aradian/MultiSpectLED/pcb-Kicad/MultiSpectLED/MultiSpectLED.kicad_pcb

## KiCad design pcb-Kicad/MultiSpectLED/MultiSpectLED.kicad_pcb (2022-05-28)

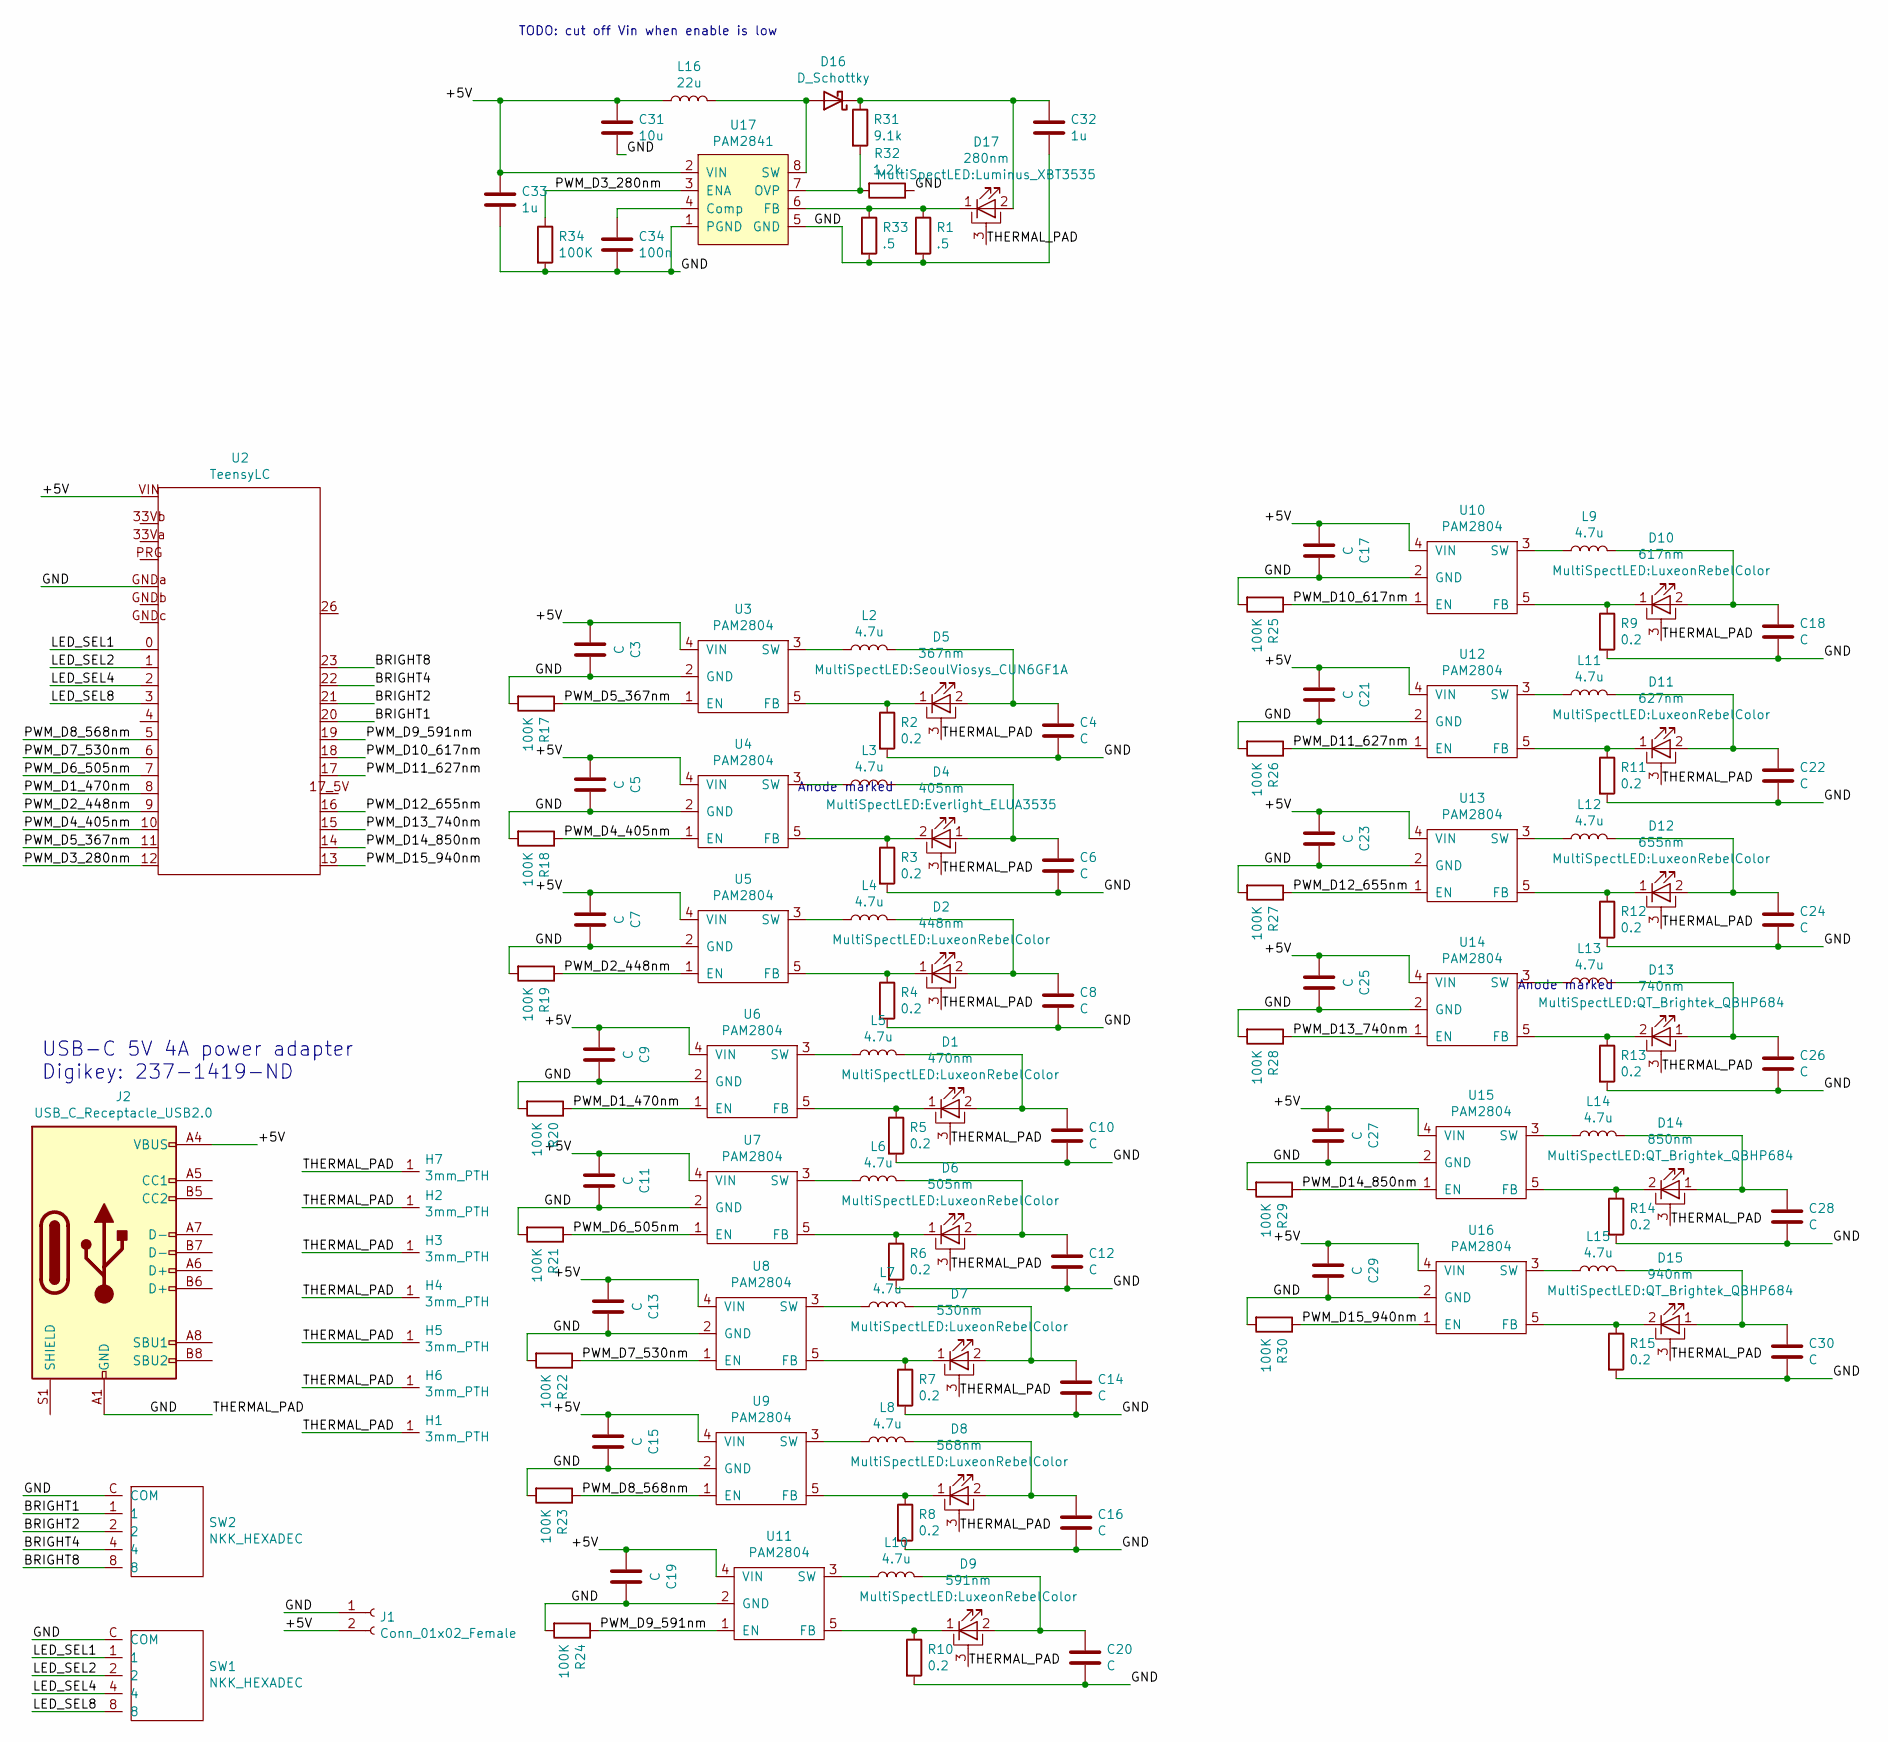
[picture p1: schematic MultiSpectLED.sch]

Parts:
C3, C4, C5, C6, C7, C8, C9, C10, C11, C12, C13, C14, C15, C16, C17, C18, C19, C20, C21, C22, C23, C24, C25, C26, C27, C28, C29, C30: C; C_0805_2012Metric; Digikey Part Number 490-3886-1-ND
C31: 10u; C_0805_2012Metric; Digi-Key_PN 1276-2891-1-ND
C32, C33: 1u; C_0805_2012Metric; Digi-Key_PN 1276-1066-1-ND
C34: 100n; C_0402_1005Metric; Digi-Key_PN 1276-1043-1-ND
D1: 470nm; LuxeonRebelColor; Digikey Part Number 1416-1029-1-ND
D2: 448nm; LuxeonRebelColor; Digikey Part Number 1416-1038-1-ND
D4: 405nm; Everlight_ELUA3535; Digikey Part Number 1080-1620-1-ND
D5: 367nm; SeoulViosys_CUN6GF1A; Digikey Part Number 2112-CUN6GF1ACT-ND
D6: 505nm; LuxeonRebelColor; Digikey Part Number 1416-1031-1-ND
D7: 530nm; LuxeonRebelColor; Digikey Part Number 1416-1036-1-ND
D8: 568nm; LuxeonRebelColor; Digikey Part Number 1416-1185-1-ND
D9: 591nm; LuxeonRebelColor; Digikey Part Number 1416-1027-1-ND
D10: 617nm; LuxeonRebelColor; Digikey Part Number 1416-1026-1-ND
D11: 627nm; LuxeonRebelColor; Digikey Part Number 1416-1024-1-ND
D12: 655nm; LuxeonRebelColor; Digikey Part Number 1416-1701-1-ND
D13: 740nm; QT_Brightek_QBHP684; Digikey Part Number 1516-1213-1-ND
D14: 850nm; QT_Brightek_QBHP684
D15: 940nm; QT_Brightek_QBHP684
D16: D_Schottky; D_TUMD2; Digi-Key_PN MSS2P2-M3/89AGICT-ND
D17: 280nm; Luminus_XBT3535; Digikey Part Number 1214-XBT-3535-UV-A130-CD270-00CT-ND
H1, H2, H3, H4, H5, H6, H7: 3mm_PTH
J1: Conn_01x02_Female; FAN_PADS
J2: USB_C_Receptacle_USB2.0; USB_C_Receptacle_Amphenol_12401610E4-2A; Digikey Part Number 12401610E4#2ACT-ND
L2, L3, L4, L5, L6, L7, L8, L9, L10, L11, L12, L13, L14, L15: 4.7u; L_1007_2518Metric; Digikey Part Number 587-1621-1-ND
L16: 22u; L_Taiyo-Yuden_NR-50xx; Digikey Part Number 587-NRS5040T220MMGKCT-ND
R1, R33: .5; R_0603_1608Metric; Digi-Key_PN CSR0603FKR500CT-ND
R2, R3, R4, R5, R6, R7, R8, R9, R10, R11, R12, R13, R14, R15: 0.2; R_0805_2012Metric; Digikey Part Number RL12S.20FCT-ND
R17, R18, R19, R20, R21, R22, R23, R24, R25, R26, R27, R28, R29, R30, R34: 100K; R_0402_1005Metric; Digikey Part Number RC1005F104CS
R31: 9.1k; R_0402_1005Metric; Digi-Key_PN RMCF0402FT9K10CT-ND
R32: 1.2k; R_0402_1005Metric; Digi-Key_PN RMCF0402FT1K20CT-ND
SW1, SW2: NKK_HEXADEC; NKK_FR02; Digikey Part Number 360-2543-1-ND
U2: TeensyLC; Digikey Part Number 1568-1233-ND
U3, U4, U5, U6, U7, U8, U9, U10, U11, U12, U13, U14, U15, U16: PAM2804; SOT-23-5; Digikey Part Number PAM2804AAB010DICT-ND
U17: PAM2841; MSOP-8_3x3mm_P0.65mm

Connections:
/+5V: C3.2, C5.2, C7.2, C9.2, C11.2, C13.2, C15.2, C17.2, C19.2, C21.2, C23.2, C25.2, C27.2, C29.2, C31.2, C33.1, J1.2, J2.A4 (VBUS), J2.A9 (VBUS), J2.B4 (VBUS), J2.B9 (VBUS), L16.1, U2.VIN, U3.4 (VIN), U4.4 (VIN), U5.4 (VIN), U6.4 (VIN), U7.4 (VIN), U8.4 (VIN), U9.4 (VIN), U10.4 (VIN), U11.4 (VIN), U12.4 (VIN), U13.4 (VIN), U14.4 (VIN), U15.4 (VIN), U16.4 (VIN), U17.2 (VIN)
/BRIGHT1: SW2.1, U2.20
/BRIGHT2: SW2.2, U2.21
/BRIGHT4: SW2.4, U2.22
/BRIGHT8: SW2.8, U2.23
/GND: C3.1, C4.2, C5.1, C6.2, C7.1, C8.2, C9.1, C10.2, C11.1, C12.2, C13.1, C14.2, C15.1, C16.2, C17.1, C18.2, C19.1, C20.2, C21.1, C22.2, C23.1, C24.2, C25.1, C26.2, C27.1, C28.2, C29.1, C30.2, C31.1, C32.2, C33.2, C34.2, D1.3 (PAD), D2.3 (PAD), D4.3 (PAD), D5.3 (PAD), D6.3 (PAD), D7.3 (PAD), D8.3 (PAD), D9.3 (PAD), D10.3 (PAD), D11.3 (PAD), D12.3 (PAD), D13.3 (PAD), D14.3 (PAD), D15.3 (PAD), D17.3 (PAD), H1.1, H2.1, H3.1, H4.1, H5.1, H6.1, H7.1, J1.1, J2.A1 (GND), J2.A12 (GND), J2.B1 (GND), J2.B12 (GND), R1.2, R2.2, R3.2, R4.2, R5.2, R6.2, R7.2, R8.2, R9.2, R10.2, R11.2, R12.2, R13.2, R14.2, R15.2, R17.2, R18.2, R19.2, R20.2, R21.2, R22.2, R23.2, R24.2, R25.2, R26.2, R27.2, R28.2, R29.2, R30.2, R32.1, R33.2, R34.2, SW1.C (COM), SW2.C (COM), U2.GNDa, U3.2 (GND), U4.2 (GND), U5.2 (GND), U6.2 (GND), U7.2 (GND), U8.2 (GND), U9.2 (GND), U10.2 (GND), U11.2 (GND), U12.2 (GND), U13.2 (GND), U14.2 (GND), U15.2 (GND), U16.2 (GND), U17.1 (PGND), U17.5 (GND)
/LED_SEL1: SW1.1, U2.0
/LED_SEL2: SW1.2, U2.1
/LED_SEL4: SW1.4, U2.2
/LED_SEL8: SW1.8, U2.3
/PWM_D1_470nm: R20.1, U2.8, U6.1 (EN)
/PWM_D2_448nm: R19.1, U2.9, U5.1 (EN)
/PWM_D3_280nm: R34.1, U2.12, U17.3 (ENA)
/PWM_D4_405nm: R18.1, U2.10, U4.1 (EN)
/PWM_D5_367nm: R17.1, U2.11, U3.1 (EN)
/PWM_D6_505nm: R21.1, U2.7, U7.1 (EN)
/PWM_D7_530nm: R22.1, U2.6, U8.1 (EN)
/PWM_D8_568nm: R23.1, U2.5, U9.1 (EN)
/PWM_D9_591nm: R24.1, U2.19, U11.1 (EN)
/PWM_D10_617nm: R25.1, U2.18, U10.1 (EN)
/PWM_D11_627nm: R26.1, U2.17, U12.1 (EN)
/PWM_D12_655nm: R27.1, U2.16, U13.1 (EN)
/PWM_D13_740nm: R28.1, U2.15, U14.1 (EN)
/PWM_D14_850nm: R29.1, U2.14, U15.1 (EN)
/PWM_D15_940nm: R30.1, U2.13, U16.1 (EN)
unnamed: C4.1, D5.2 (A), L2.2
unnamed: C6.1, D4.1 (A), L3.2
unnamed: C8.1, D2.2 (A), L4.2
unnamed: C10.1, D1.2 (A), L5.2
unnamed: C12.1, D6.2 (A), L6.2
unnamed: C14.1, D7.2 (A), L7.2
unnamed: C16.1, D8.2 (A), L8.2
unnamed: C18.1, D10.2 (A), L9.2
unnamed: C20.1, D9.2 (A), L10.2
unnamed: C22.1, D11.2 (A), L11.2
unnamed: C24.1, D12.2 (A), L12.2
unnamed: C26.1, D13.1 (A), L13.2
unnamed: C28.1, D14.1 (A), L14.2
unnamed: C30.1, D15.1 (A), L15.2
unnamed: C32.1, D16.1 (K), D17.2 (A), R31.1
unnamed: C34.1, U17.4 (Comp)
unnamed: D1.1 (K), R5.1, U6.5 (FB)
unnamed: D2.1 (K), R4.1, U5.5 (FB)
unnamed: D4.2 (K), R3.1, U4.5 (FB)
unnamed: D5.1 (K), R2.1, U3.5 (FB)
unnamed: D6.1 (K), R6.1, U7.5 (FB)
unnamed: D7.1 (K), R7.1, U8.5 (FB)
unnamed: D8.1 (K), R8.1, U9.5 (FB)
unnamed: D9.1 (K), R10.1, U11.5 (FB)
unnamed: D10.1 (K), R9.1, U10.5 (FB)
unnamed: D11.1 (K), R11.1, U12.5 (FB)
unnamed: D12.1 (K), R12.1, U13.5 (FB)
unnamed: D13.2 (K), R13.1, U14.5 (FB)
unnamed: D14.2 (K), R14.1, U15.5 (FB)
unnamed: D15.2 (K), R15.1, U16.5 (FB)
unnamed: D16.2 (A), L16.2, U17.8 (SW)
unnamed: D17.1 (K), R1.1, R33.1, U17.6 (FB)
unnamed: L2.1, U3.3 (SW)
unnamed: L3.1, U4.3 (SW)
unnamed: L4.1, U5.3 (SW)
unnamed: L5.1, U6.3 (SW)
unnamed: L6.1, U7.3 (SW)
unnamed: L7.1, U8.3 (SW)
unnamed: L8.1, U9.3 (SW)
unnamed: L9.1, U10.3 (SW)
unnamed: L10.1, U11.3 (SW)
unnamed: L11.1, U12.3 (SW)
unnamed: L12.1, U13.3 (SW)
unnamed: L13.1, U14.3 (SW)
unnamed: L14.1, U15.3 (SW)
unnamed: L15.1, U16.3 (SW)
unnamed: R31.2, R32.2, U17.7 (OVP)

Notes on the sheet:
Anode marked
USB-C 5V 4A power adapter Digikey: 237-1419-ND
TODO: cut off Vin when enable is low

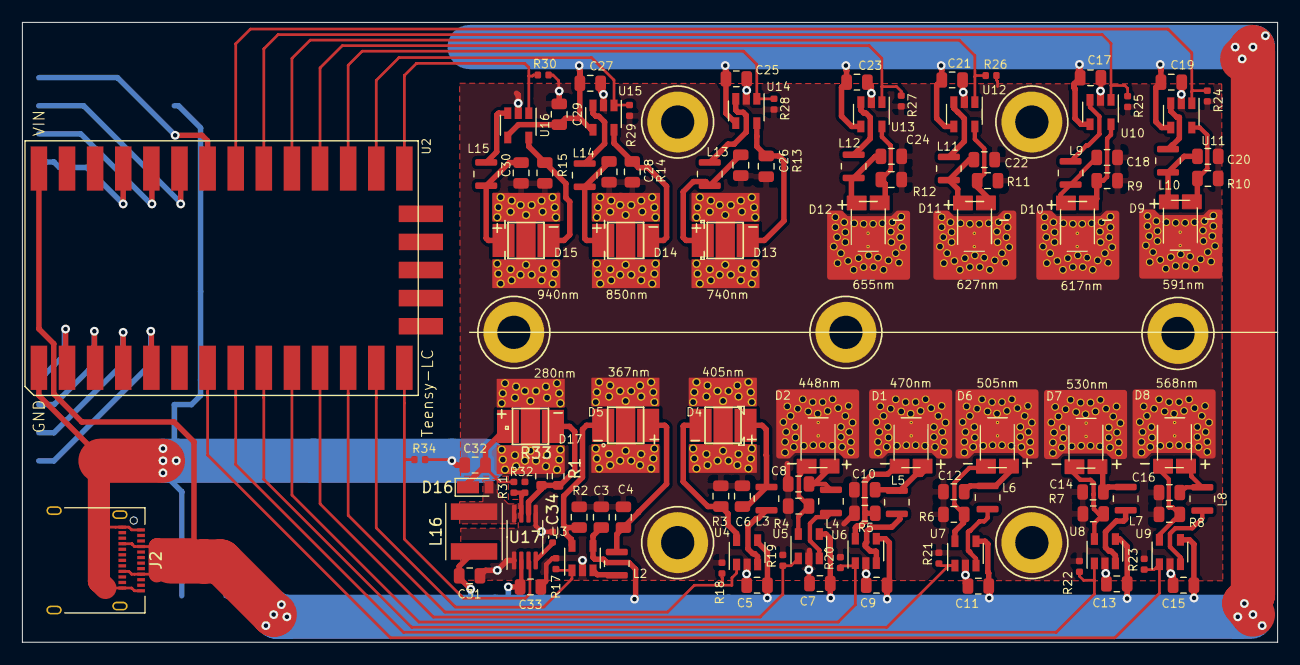
[picture p2: board MultiSpectLED.kicad_pcb from above]

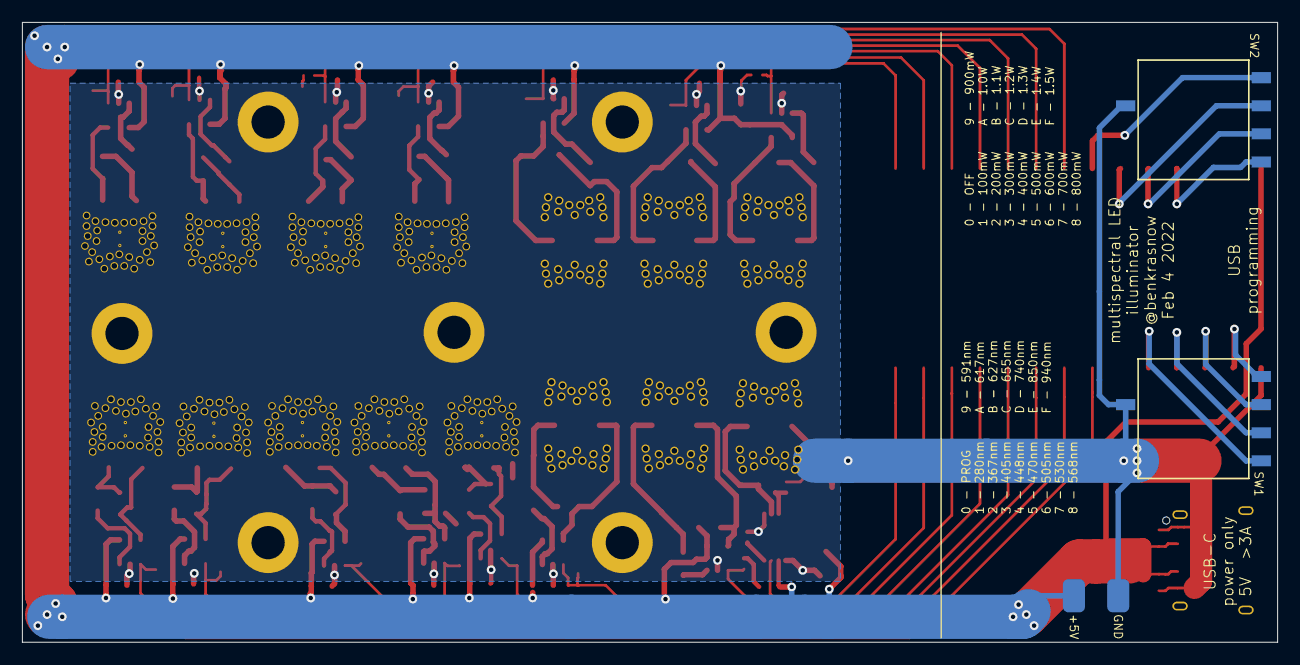
[picture p3: board MultiSpectLED.kicad_pcb from below]

Board: 2 copper layers, 113.4 x 56.0 mm, 123 parts (3 on the bottom side), 72 nets.
